zhemufengtailang57-art/edge-vibration-diagnosis/hardware/README.md

# 硬件设计

STM32F407 振动监测终端主控板 —— 原理图与 PCB Layout。

设计工具：**嘉立创EDA 专业版** V3.2.166

| 板卡规格 | |
|---|---|
| 层数 | **4 层板** —— 叠层：信号 / GND / 电源 / 信号 |
| 主控 | STM32F407ZGT6（LQFP144，168 MHz） |
| 供电 | 12V DC 输入，板载 3.3V（MP2315）/ 5V（HT7150）双路 |
| 打样 | 嘉立创 |

---

## 一、图纸索引

### 原理图（共 5 页）

| 页码 | 内容 | 图纸 | 说明 |
|---|---|---|---|
| 1 | STM32 最小系统 | [`schematic/01_STM32最小系统.png`](schematic/01_STM32最小系统.png) | 主控、时钟、复位、BOOT/SWD、VCAP/VDDA、W25Q64、去耦 |
| 2 | 电源树 | [`schematic/02_电源树.png`](schematic/02_电源树.png) | 12V 输入保护 → 3.3V (MP2315) / 5V (HT7150) |
| 3 | 传感器 | [`schematic/03_传感器.png`](schematic/03_传感器.png) | ADXL345 加速度计、DS18B20 温度传感器接线 |
| 4 | 电机与输出 | [`schematic/04_电机与输出.png`](schematic/04_电机与输出.png) | TB6612 驱动、LED 指示、蜂鸣器、电机开关 |
| 5 | 通信接口 | [`schematic/05_通信接口.png`](schematic/05_通信接口.png) | USB Type-C、ESP32、OLED、MAX13487 RS485 |

### PCB

| 内容 | 文件 |
|---|---|
| 3D 渲染图（器件装配效果） | [`pcb/VibrationMonitor_F407_3D.png`](pcb/VibrationMonitor_F407_3D.png) |
| Layout 总览（丝印 / 走线 / 器件布局） | [`pcb/VibrationMonitor_F407_PCB_Layout.png`](pcb/VibrationMonitor_F407_PCB_Layout.png) |
| 嘉立创EDA 工程源文件（可编辑） | [`VibrationMonitor_F407_嘉立创EDA工程.epru`](VibrationMonitor_F407_嘉立创EDA工程.epru) |

<p align="center">
  3D 渲染
</p>

> 工程源文件用嘉立创EDA 专业版打开：`文件 → 打开 → 选择 .epru`。

---

## 二、关键器件

| 功能 | 器件 | 封装 / 型号 | 接口 |
|---|---|---|---|
| 主控 | STM32F407ZGT6 | LQFP144，168 MHz | — |
| 振动传感器 | ADXL345 | 三轴加速度计 | SPI1 |
| 温度传感器 | DS18B20 | 1-Wire 数字温度 | GPIO |
| 存储 | W25Q64 | 8 MB SPI Flash | SPI2 |
| 显示 | OLED 128×64 | SSD1306 | I2C1 |
| 电机驱动 | TB6612FNG | 双路 H 桥 | PWM (TIM3) |
| 有线通信 | MAX13487EESA | RS485 自动方向 | USART3 |
| 无线通信 | ESP32-WROOM-32 | Wi-Fi / MQTT | USART1 |
| 电源 | MP2315GJ-Z | 同步降压 → 3.3V | — |
| 电源 | HT7150 | LDO → 5V | — |

---

## 三、电源树

```
  12V DC (DC005)
      │
      ├─ F2: SMD1206-200-16 自恢复保险丝
      │
      ├─ Q1: AO3401A PMOS 电源开关（R1 10kΩ 上拉栅极）
      │
      └─── VCC_12V ──┬──────────────────────────┐
                     │                          │
              U1: MP2315GJ-Z              U8: HT7150
              (同步降压, 2A)              (LDO)
                     │                          │
                  VCC_3V3                    VCC_5V
              (数字 / 模拟 / 传感器)      (RS485 / 蜂鸣器)
```

- 输入端 100µF 电解 + 100nF 陶瓷去耦，抑制电机启停的电流冲击
- 3.3V 侧按 VCC / VDDA / VCAP 分区去耦，模拟供电独立走线
- RS485 与蜂鸣器走 5V，避免电机噪声串扰数字域

---

## 四、设计要点

**1. 4 层板叠层：信号 / GND / 电源 / 信号**
第 2 层为完整 GND 平面，为第 1 层的高速信号（SPI 5.25 MHz、8 MHz 晶振）提供紧耦合回流路径；同时把信号层与第 3 层电源层隔开，避免电源噪声耦合进 ADXL345 这类 mG 量级的敏感模拟电路。相比两层板，四层板把回流路径从"绕行"变成"就近"，是 EMI 与信号完整性最直接的一层保险。

**2. 电源与电机隔离**
TB6612 的电机供电（VM）与逻辑供电（VCC）分开走线，各自独立去耦（C32/C33、C34）。电机是大电流感性负载，启停瞬间的反电动势容易通过电源串扰到 MCU，分区去耦是最直接的抑制手段。

**3. RS485 自动方向**
选用 MAX13487EESA 而非传统的 MAX3485 + DE 控制线方案。前者内置自动方向控制，省去一路 GPIO 和软件切换时序，代价是**波特率受内部超时限制**——实测降到 57600 会导致帧尾被提前撤销，因此固件锁定 115200（详见 `docs/调试踩坑记录.docx`）。

**4. 传感器接线端子化**
ADXL345 与 DS18B20 均通过端子（DB125-2.54-8P、WJ500V-5.08-03P）外接，而非直接焊在板上。振动传感器需要贴装在电机壳体上，走线长度和位置直接影响信号质量，端子化便于现场调整。

**5. 磁珠隔离电源**
ADXL345 供电串入 BLM18AG601SN1D 磁珠（600Ω@100MHz），抑制高频噪声从数字电源耦合进加速度计——振动信号幅度在 mG 量级，电源纹波会直接污染测量结果。

---

## 五、图纸导出说明

`schematic/` 与 `pcb/` 下的 PNG 由嘉立创EDA 导出，可直接在 GitHub 上预览，无需安装任何 EDA 工具。
`.epru` 为工程源文件，如需修改设计请用嘉立创EDA 专业版打开。
