zhemufengtailang57-art/edge-vibration-diagnosis/docs/软件交接文档_2026-08-16.md

# 软件交接文档（振动监测项目）

> 生成日期：2026-08-16
> 用途：对话上下文过长时，新对话读此文档即可恢复全部项目状态
> 配套参考：memory/project-plan.md（项目全貌）、调试踩坑记录.docx（23坑）、项目开发日志.docx

---

## 一、项目当前状态（截至 2026-08-16）

### 已完成 ✅
- 面包板全链路验证跑通：ADXL345(SPI1) / DS18B20(OneWire PB5) / OLED(I2C1) / W25Q64(SPI2) / MAX3485(USART3)
- FreeRTOS 5任务：Sensor / Display / MQTT / Modbus / Watchdog
- TIM4 1kHz 双缓冲采样（128组/块）+ MA8+MED5 滤波管线 + FFT 128点（CMSIS-DSP）
- Modbus-RTU 从站：USART3 115200，RXNE 中断 + 256B 环形缓冲，寄存器直读直写，500ms+ 轮询 100% 可靠
- MQTT：F407 USART1 发 JSON → ESP32 → WiFi → Broker（PC Mosquitto）
- IWDG 16s + TIM4 中断喂狗（500ms/次）
- 黑匣子：W25Q64 故障记录 500+ 条
- 上位机：Qt6 工业版（双视图/曲线/CSV导出）+ Grafana + 手机网页监控
- **PCB 硬件设计已完成**：5页原理图 0/0/0 ERC，4层板布局布线完成，DRC 0 错误，Gerber 已出（2026-08-16），待下单打样

### 面包板电机实测（2026-08-11 左右）
- 电机可转动；上电瞬间不乱转，F407 复位完成后开始转（固件测试代码启动）
- 面包板无 PC6/PC7 下拉电阻，PCB 版已加 10kΩ 下拉（硬件保护复位期浮空）

---

## 二、PCB 硬件与面包板的差异（固件必须知道的）

| # | 差异 | 影响 |
|---|---|---|
| 1 | **LSE 32.768kHz 外部晶振新增**（PC14/PC15） | 🔴 CubeMX 必须改 RCC LSE=Crystal，否则晶振白焊、RTC 仍跑 LSI |
| 2 | **PB0 改为蜂鸣器**（原 ESP8266 EN，已废弃） | 需新增蜂鸣器驱动代码 |
| 3 | **PA0 黄灯、PA1 红灯新增** | 需新增 LED 控制代码（绿灯 PC0 已是心跳灯，无需改） |
| 4 | **MPU6050 已从 PCB 移除** | 代码里 MPU6050_ReadAccel 读取但值未用，可删 |
| 5 | RS485 芯片 = MAX13487E（5V 供电，HT7150 单独供 5V） | 逻辑电平已验证兼容（PB11/PD8 均 FT 脚） |
| 6 | MAX13487E 无 DE 脚：Pin2=RE、Pin3=SHDN，短接后 10kΩ 上拉到 5V = AutoDirection 自动收发 | 默认 0Ω 不焊，无需代码控制方向 |
| 7 | 0Ω(DNP) 接 PC8 = 备份：焊上后 PC8 拉低 = 关断 485 芯片（软件复位用） | 不是方向控制！ |
| 8 | PC6/PC7 各 10kΩ 下拉（复位期防电机误动） | 代码无需改，Motor_Init 已有 |
| 9 | ESP32 模组 = ESP32-S3-WROOM-1（邮票孔，USB 原生烧录口） | ESP32 固件按 S3 配置（GPIO16=RX2、GPIO17=TX2） |
| 10 | USART3 115200（面包板最终配置） | modbus_slave.c:128 的 LOG 还写着"9600 8N1"，是旧日志没改 |
| 11 | 电机物理开关 SW3（12V 到 TB6612 VM 之间） | 演示时手动控制电机通断电 |

---

## 三、软件待办清单（按优先级）

### 🔴 P0：CubeMX 改 LSE（必做，不改 PCB 白焊）
1. 打开 Vibration_F407.ioc → System Core → RCC → LSE 选 **Crystal/Ceramic Resonator**
2. Clock Configuration 里 RTC 时钟源选 LSE
3. Generate Code **前先备份 main.c 全文**
4. Generate 后逐项检查（历史踩坑）：
   - MX_IWDG_Init() 位置（必须挪到 osKernelStart() 前，否则看门狗提前启动复位循环）
   - USART3 波特率是否被改回 9600（必须 115200）
   - FreeRTOS 任务函数体是否被清空（USER CODE 标记断裂，历史坑14）
   - HAL 时基 TIM6、中断优先级

### 🟡 P1：新增 PCB 输出驱动（蜂鸣器 + 黄灯 + 红灯）
初始化（main.c USER CODE BEGIN 2）：
```c
HAL_GPIO_WritePin(GPIOA, GPIO_PIN_0 | GPIO_PIN_1, GPIO_PIN_SET); // 黄/红灭（低电平亮）
HAL_GPIO_WritePin(GPIOB, GPIO_PIN_0, GPIO_PIN_RESET);             // 蜂鸣器不响
```
阈值逻辑骨架（sensorTask 每轮采样后，阈值待 AI 训练后替换）：
```c
if (fft_result.rms > 2.0f) {          // 故障：红亮+蜂鸣
    PA1=0; PA0=1; PB0=1;
} else if (fft_result.rms > 0.5f) {   // 预警：黄亮
    PA0=0; PA1=1; PB0=0;
} else {                              // 正常：全灭，绿灯心跳
    PA0=1; PA1=1; PB0=0;
}
```

### 🟡 P2：RS485 方向备份（仅当 AutoDirection 丢包才做）
- 现状：modbus_slave.c 发送用寄存器直写，未调用方向切换
- 若 115200 下丢包：焊上 0Ω，代码在 Modbus_Poll 发送前 `RS485_SetTx()`、`while(TC)` 后 `RS485_SetRx()`（函数已存在于 modbus_slave.c:102-110，只是没被调用）
- 注意：MAX13487E 拉低 RE/SHDN = 关断芯片，不是方向控制；备份用途是"软件复位 485"

### 🟢 P3：代码清理（不强制）
| 项 | 操作 |
|----|---|
| 删除 MPU6050 | mpu6050.c/h + main.c include + sensorTask 里的 ReadAccel 调用 + ax/ay/az 变量 |
| 删除 ESP8266 | esp8266.c/h + main.c include |
| I2C1 互斥锁 | 可选删（I2C1 上只剩 OLED 一个设备） |
| Modbus 日志 | modbus_slave.c:128 的 "9600 8N1" 改为 "115200 8N1" |

---

## 四、关键文件与代码位置（`firmware/`）

| 文件 | 内容 |
|---|---|
| Core/Inc/main.h | GPIO 宏定义（LED_Pin=PC0, ESP8266_Pin=PB0[已改蜂鸣器], RS485_DE_Pin=PC8, W25Q64_CS_Pin=PB12） |
| Core/Src/main.c | 5 任务 + SystemClock_Config(168MHz) + sensorTask 主逻辑 + TIM4 回调喂狗 |
| Core/Src/adxl345_dma.c | 双缓冲采样，ADXL_DMA_TIM4_ISR 在 TIM4 中断里调 |
| Core/Src/filter.c | MA(8)+MED(5) 滤波管线 |
| Core/Src/fft_analyzer.c | 128 点 RFFT + RMS + 峰值搜索（RMS<10mg 判静止 valid=0） |
| Core/Src/modbus_slave.c | Modbus 从站（0x03/0x04/0x06，寄存器表 7+2），USART3 寄存器直写，RS485_SetTx/Rx 已定义未调用 |
| Core/Src/motor.c | TB6612：Motor_Init/Start/Stop/Forward/Reverse/SetSpeed(0-999) |
| Core/Src/w25q64.c | Flash 驱动 + 黑匣子（BLACKBOX_ADDR=4096，500 条×16B） |
| Core/Src/ds18b20.c | OneWire PB5，DWT 微秒延时，12bit |
| Core/Src/mqtt_simple.c | MQTT v3.1.1 手动协议栈（ESP8266 AT 遗留，ESP32 方案已改 USART1 直发 JSON） |
| Core/Src/stm32f4xx_hal_msp.c | PB11 已手动加 GPIO_PULLUP（生成代码别覆盖） |
| Vibration_F407.ioc | CubeMX 配置（改 LSE 用） |

### 引脚分配锁定表（PCB 已按此设计，不可改）
- USART1: PA9(TX)/PA10(RX) → ESP32
- USART2: PA2/PA3 → 调试
- USART3: PD8(TX)/PB11(RX) → MAX13487E
- PC8: RS485_DE（0Ω 备份）
- I2C1: PB6/PB7 → OLED
- SPI1: PA5/PA6/PA7 + PA4(CS) → ADXL345
- SPI2: PB10(SCK)/PC2(MISO)/PC3(MOSI) + PB12(CS) → W25Q64 ⚠️ 非标引脚
- TIM3_CH4: PB1 → 电机 PWM 1kHz
- PC6/PC7: 电机 AIN1/AIN2；PB2: STBY+BOOT1
- PB5: DS18B20
- PC0: 绿 LED；PA0: 黄；PA1: 红；PB0: 蜂鸣器

---

## 五、下一个里程碑（PCB 到货后）

1. **打样等待期**（1-2 周）：改 CubeMX LSE + 补蜂鸣器/LED 驱动 + 代码清理
2. **PCB 焊接**：先电源区测 3.3V/5V → 焊 F407 测 SWD → W25Q64 → RS485 → ESP32 烧录 → 电机最后上电
3. **上电测试清单**：万用表测 3V3/GND 无短路 → 只插电源测三轨电压 → ST-Link 读 ID → 烧面包板固件看 OLED/串口
4. **AI 模型训练**：PC 采集 → FFT 特征 → MLP/CNN/LGB 对比 → int8 量化 → Cube.AI 部署
5. **阈值标定**：替换 P1 里的 0.5/2.0 占位阈值
6. **外壳**：立创铝型材外壳 + 前面板开孔（OLED 窗口/三色灯孔/开关孔/端子口）
7. **文档**：更新项目开发日志 + 调试踩坑记录（软硬联调审计结果可入文档）

---

## 六、教学方式铁律（新对话必须遵守）

1. 每一步列完整操作细节（点哪个菜单、选什么、填什么值）
2. 代码写在哪、USER CODE BEGIN/END 哪个块之间要讲清楚
3. 出错了先要现象描述 → 分析根因 → 给修复步骤，不让用户自己猜
4. CubeMX Generate Code 必毁三样：IWDG 位置、波特率、USER CODE 块——每次生成后检查
5. 用户指出错误时，承认并立即修正，不狡辩
6. 一切以跑通版本为准，不确定的先问再动
