zhemufengtailang57-art/edge-vibration-diagnosis/docs/CubeMX配置速查手册.docx

# STM32CubeMX 配置速查手册 (Vibration_F407项目)

芯片: STM32F407ZGT6 | 封装: LQFP144 | CubeMX版本: 6.17.0

# 一、初始工程配置

## 1.1 新建工程

打开CubeMX → File → New Project → 选STM32F407ZGTx

Pinout → System Core → SYS:

Debug: Serial Wire (⚠️ 必须配!否则ST-Link连不上)

Pinout → System Core → RCC:

High Speed Clock(HSE): Crystal/Ceramic Resonator

Clock Configuration:

HSE=8MHz → PLLM=/8 → PLLN=×168 → PLLP=/2 → SYSCLK=168MHz

APB1=/4=42MHz, APB2=/2=84MHz

Project Manager → Project Name: Vibration_F407

Toolchain: MDK-ARM V5.32

⚠️ 勾选 "Keep User Code when re-generating"

## 1.2 每次Generate后必检查

⚠️ 删除 peripheral init区多余的 MX_IWDG_Init()

⚠️ 删除 osKernelStart()后的孤儿 while(1){}

⚠️ 确认任务优先级没被重置(all Normal→需手动改回)

⚠️ 确认 sensorTask 函数体没被清空(USER CODE 5→StartSensorTask)

# 二、外设配置

## 2.1 USART2 — 调试串口 printf (PA2/PA3)

Connectivity → USART2 → Mode: Asynchronous

Parameter Settings: Baud=115200, 8N1

代码: fputc重定向到huart2, Keil勾选Use MicroLIB

## 2.2 USART1 — ESP8266 WiFi (PA9/PA10)

Connectivity → USART1 → Mode: Asynchronous

Parameter Settings: Baud=115200, 8N1

⚠️ 正点原子板: 拔掉PA9-RX/PA10-TX的跳帽!

代码: PB0=GPIO_Output(EN), 独立3.3V供电(不接ST-Link)

## 2.3 USART3 — RS485 Modbus (PD8/PB11)

Connectivity → USART3 → Mode: Asynchronous

Parameter Settings: Baud=115200, 8N1

PC8: GPIO_Output = RS485_DE (收发控制, HIGH=TX, LOW=RX)

## 2.4 I2C1 — OLED+MPU6050 (PB6/PB7)

Connectivity → I2C1 → Mode: I2C

Parameter Settings: Standard Mode, 100kHz

GPIO Settings: PB6/PB7 → Alternate Function Open Drain + Pull-up

💡 两个设备同总线, 地址不同(OLED=0x3C, MPU=0x68) — 互斥锁保护

## 2.5 SPI1 — ADXL345 (PA4=CS, PA5=SCK, PA6=MISO, PA7=MOSI)

Connectivity → SPI1 → Mode: Full-Duplex Master

Parameter Settings:

Data Size=8Bit, MSB First

CPOL=High, CPHA=2 Edge (Mode 3)

NSS=Software (手动CS)

Baud Rate Prescaler=16 → 5.25MHz

PA4: GPIO_Output = CS (不选SPI1_NSS, 软件控制)

⚠️ PA5同时是之前LED脚 → LED移走(PC0)

## 2.6 SPI2 — W25Q64 Flash (PB10=SCK, PC2=MISO, PC3=MOSI, PB12=CS)

Connectivity → SPI2 → Mode: Full-Duplex Master

Parameter Settings:

CPOL=Low, CPHA=1 Edge (Mode 0)

NSS=Software

Baud Rate=16 → 2.625MHz (APB1/16=42/16)

PB12: GPIO_Output = CS

💡 SPI2引脚映射是PB10/PC2/PC3,不是常见的PB13/14/15 — CubeMX自动选的

## 2.7 PB5 — DS18B20 OneWire

GPIO → PB5: GPIO_Output (驱动代码里动态切换输入/输出)

⚠️ 不需要CubeMX配置OneWire — 纯软件模拟, DWT计时

硬件: 4.7kΩ上拉电阻在VCC和DATA之间

# 三、定时器与PWM

## 3.1 TIM3 CH4 — TB6612电机PWM (PB1)

Timers → TIM3 → Clock Source: Internal Clock

Channel 4: PWM Generation CH4

Parameter Settings:

Prescaler=83 → 1MHz (84M/84)

Counter Period=999 → 1kHz PWM

Auto-reload=Enable

PB1自动变TIM3_CH4 (AF2)

💡 1kHz是电机PWM最优频率 — 噪声和效率折中

## 3.2 TIM4 — ADXL345 1kHz采样触发

Timers → TIM4 → Clock Source: Internal Clock

Parameter Settings:

Prescaler=83, Counter Period=999 → 1kHz

NVIC Settings → TIM4 global interrupt → 勾选 ✅

⚠️ 不要配任何Channel — TIM4只当中断闹钟用

代码: HAL_TIM_PeriodElapsedCallback里读取ADXL345

## 3.3 SYS Timebase → TIM6 (FreeRTOS启用后必配)

System Core → SYS → Timebase Source: TIM6

⚠️ FreeRTOS启用后必须改!否则SysTick冲突

⚠️ 每次新建工程配完FreeRTOS后立即改这个

# 四、FreeRTOS 完整配置

## 4.1 启用FreeRTOS

Middleware → FREERTOS → Interface: CMSIS_V2

Config parameters:

TOTAL_HEAP_SIZE = 20480 (20KB)

TICK_RATE_HZ = 1000

⚠️ 立刻去SYS把Timebase改成TIM6!

## 4.2 添加任务 (Tasks标签)

点击Add, 逐一添加5个任务:

sensorTask: Priority=osPriorityAboveNormal, Stack=1024×4=4096B

displayTask: Priority=osPriorityNormal, Stack=512×4=2048B

mqttTask: Priority=osPriorityNormal, Stack=1024×4=4096B

modbusTask: Priority=osPriorityNormal, Stack=512×4=2048B

watchdogTask: Priority=osPriorityBelowNormal, Stack=256×4=1024B

💡 优先级: AboveNormal(采集) > Normal(显示/通信) > BelowNormal(监控)

💡 Stack: sensor/mqtt要4KB(FFT数组/MQTT缓冲), 其他2KB够了

## 4.3 互斥锁 (Mutexes标签)

点击Add → Name: i2c1Mutex

代码: osMutexAcquire/Release 保护I2C1总线

CubeMX生成的句柄: i2c1MutexHandle

用法:

osMutexAcquire(i2c1MutexHandle, osWaitForever);

// ... I2C操作 ...

osMutexRelease(i2c1MutexHandle);

## 4.4 队列 (Queues标签) — 当前未用

点击Add → Name: sensorQueue, Size=16, Type=uint16_t

💡 队列已创建但未使用, 当前用Task Notification替代

💡 以后加AI任务或更多消费者时用队列分发数据

# 五、看门狗IWDG

## 5.1 IWDG 配置

System Core → IWDG → Activated ✅

Prescaler=128, Reload value=4095 → 16秒超时

⚠️ CubeMX在peripheral init区插入 MX_IWDG_Init()

⚠️ 必须手动删除! 在main()末尾(while前)调用

正确初始化顺序:

1. 所有外设Init

2. 所有传感器检测

3. ESP8266 WiFi连接

4. MX_IWDG_Init() ← 最后一步

5. osKernelStart()

喂狗: 在TIM4中断回调里, 每500ms HAL_IWDG_Refresh(&hiwdg)

💡 在中断喂狗比在任务喂狗可靠100倍(不受任务调度影响)

# 六、GPIO快速参考

## 引脚分配总表

PA2=USART2_TX, PA3=USART2_RX (printf调试串口)

PA4=ADXL345_CS (SPI1软件CS, GPIO_Output)

PA5=SPI1_SCK, PA6=SPI1_MISO, PA7=SPI1_MOSI (ADXL345)

PA9=USART1_TX, PA10=USART1_RX (ESP8266, 拔跳帽!)

PA13=SWDIO, PA14=SWCLK (ST-Link, 勿动!)

PB0=ESP_EN (GPIO_Output, 高电平使能ESP8266)

PB1=TIM3_CH4 (电机PWM, 1kHz)

PB5=DS18B20 OneWire (GPIO, 4.7k上拉)

PB6=I2C1_SCL, PB7=I2C1_SDA (OLED+MPU6050共享)

PB10=SPI2_SCK, PC2=SPI2_MISO, PC3=SPI2_MOSI (W25Q64)

PB11=USART3_RX, PD8=USART3_TX (RS485 Modbus)

PB12=W25Q64_CS (SPI2软件CS, GPIO_Output)

PC0=LED (GPIO_Output, 500ms闪烁)

PC6/PC7=TB6612 AIN1/AIN2 (电机方向, GPIO_Output)

PC8=RS485_DE (收发控制, GPIO_Output)

PH0=OSC_IN, PH1=OSC_OUT (HSE 8MHz晶振)

# 七、常见踩坑速查

## 每次CubeMX Generate后必做

1. 打开main.c → 删 peripheral init 区的 MX_IWDG_Init()

2. 删 osKernelStart() 后的孤儿 while(1){} 块

3. 检查任务优先级(每个Task属性里改: sensor=AboveNormal, mqtt=Normal, watchdog=BelowNormal)

4. 检查 SYS Timebase= TIM6

5. 检查 sensorTask 函数体是否被清空(StartSensorTask → 如果被清空,重写)

6. 检查 FreeRTOSConfig.h → configENABLE_FPU? (F407有硬浮点)

7. F7编译 → 有孤儿while错误 → 删孤儿块 + 补 /* USER CODE BEGIN 3 */ 和 }

8. Keil Options: C/C++ → Define → ARM_MATH_CM4 (FFT用DSP库)

9. Keil Options: Target → Floating Point = Single Precision

# 八、工具链版本

CubeMX: 6.17.0 | HAL: STM32Cube FW_F4 V1.28.3 | Keil: MDK-ARM V5.32 | 编译器: ARMCC V5.06

FreeRTOS: V10.3.1 (CMSIS_V2 wrapper) | CMSIS-DSP: V1.9.0 | Node-RED: V5.0.1
