zhemufengtailang57-art/edge-vibration-diagnosis/hardware/schematic/01_STM32最小系统.png

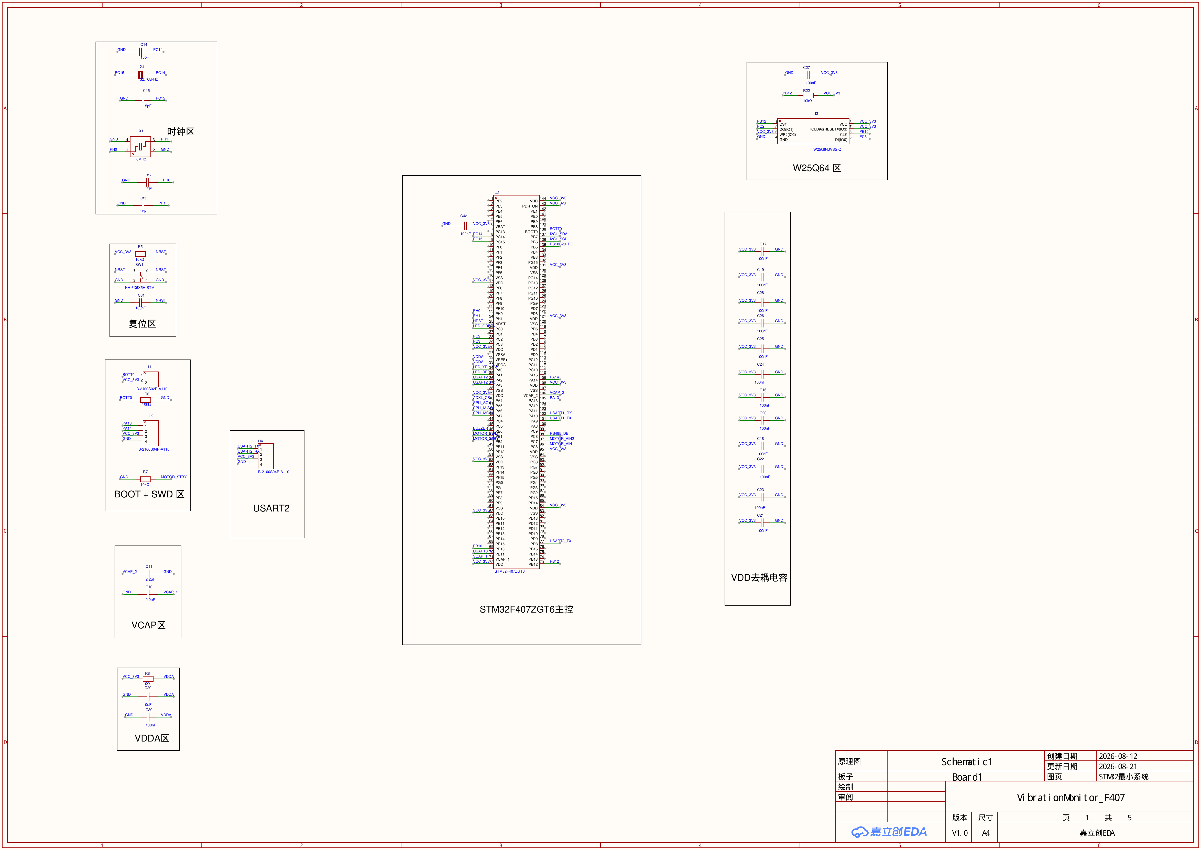
hardware/schematic/01_STM32最小系统.png
