zhemufengtailang57-art/edge-vibration-diagnosis/hardware/schematic/02_电源树.png

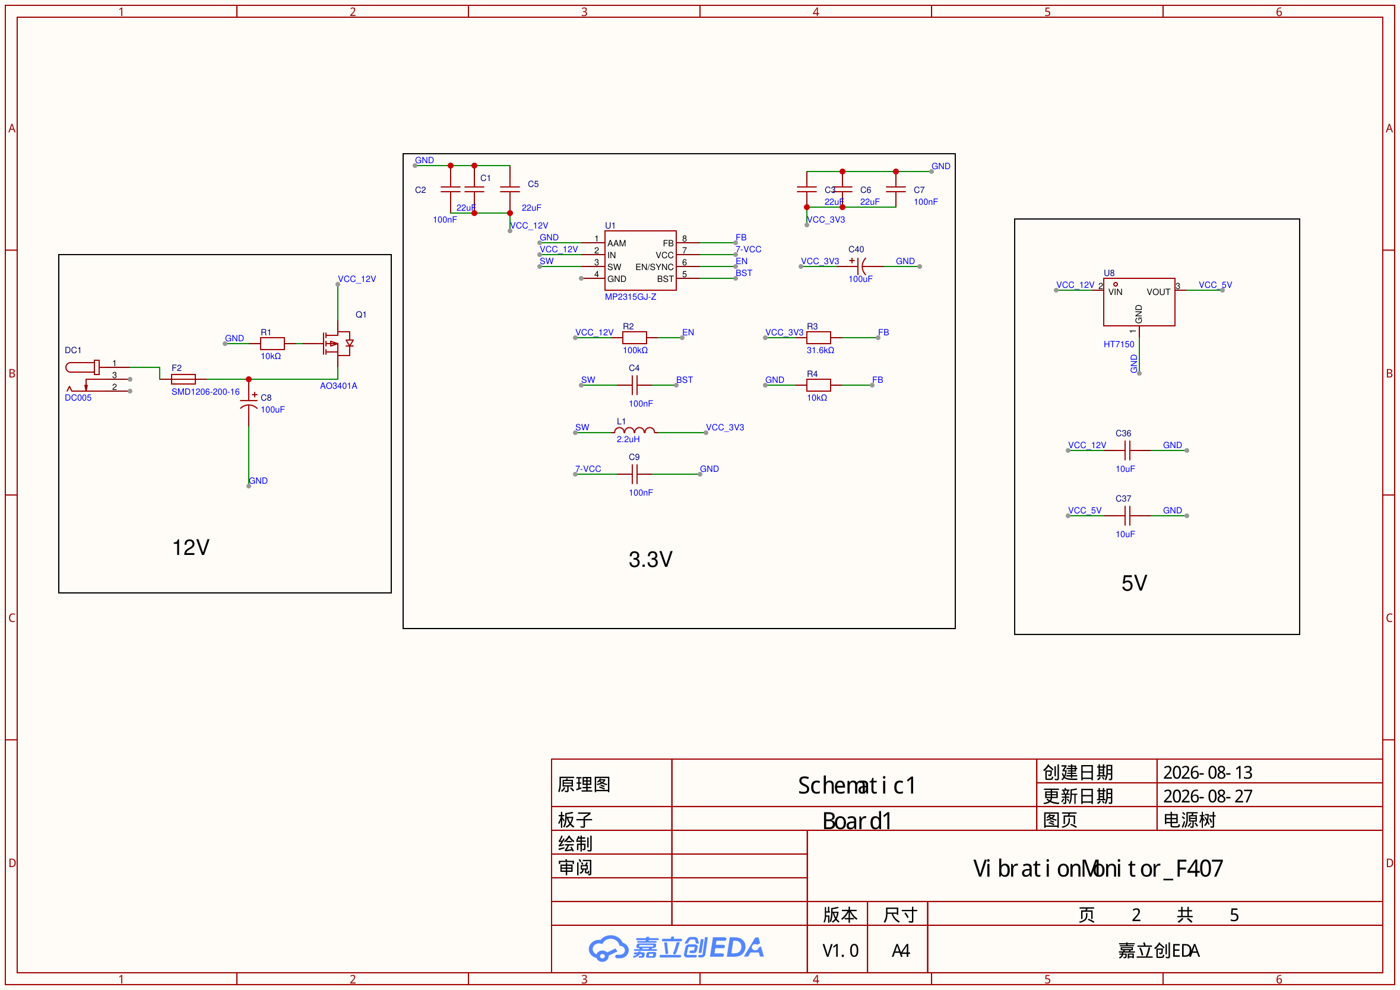
hardware/schematic/02_电源树.png
