zhemufengtailang57-art/edge-vibration-diagnosis/hardware/schematic/03_传感器.png

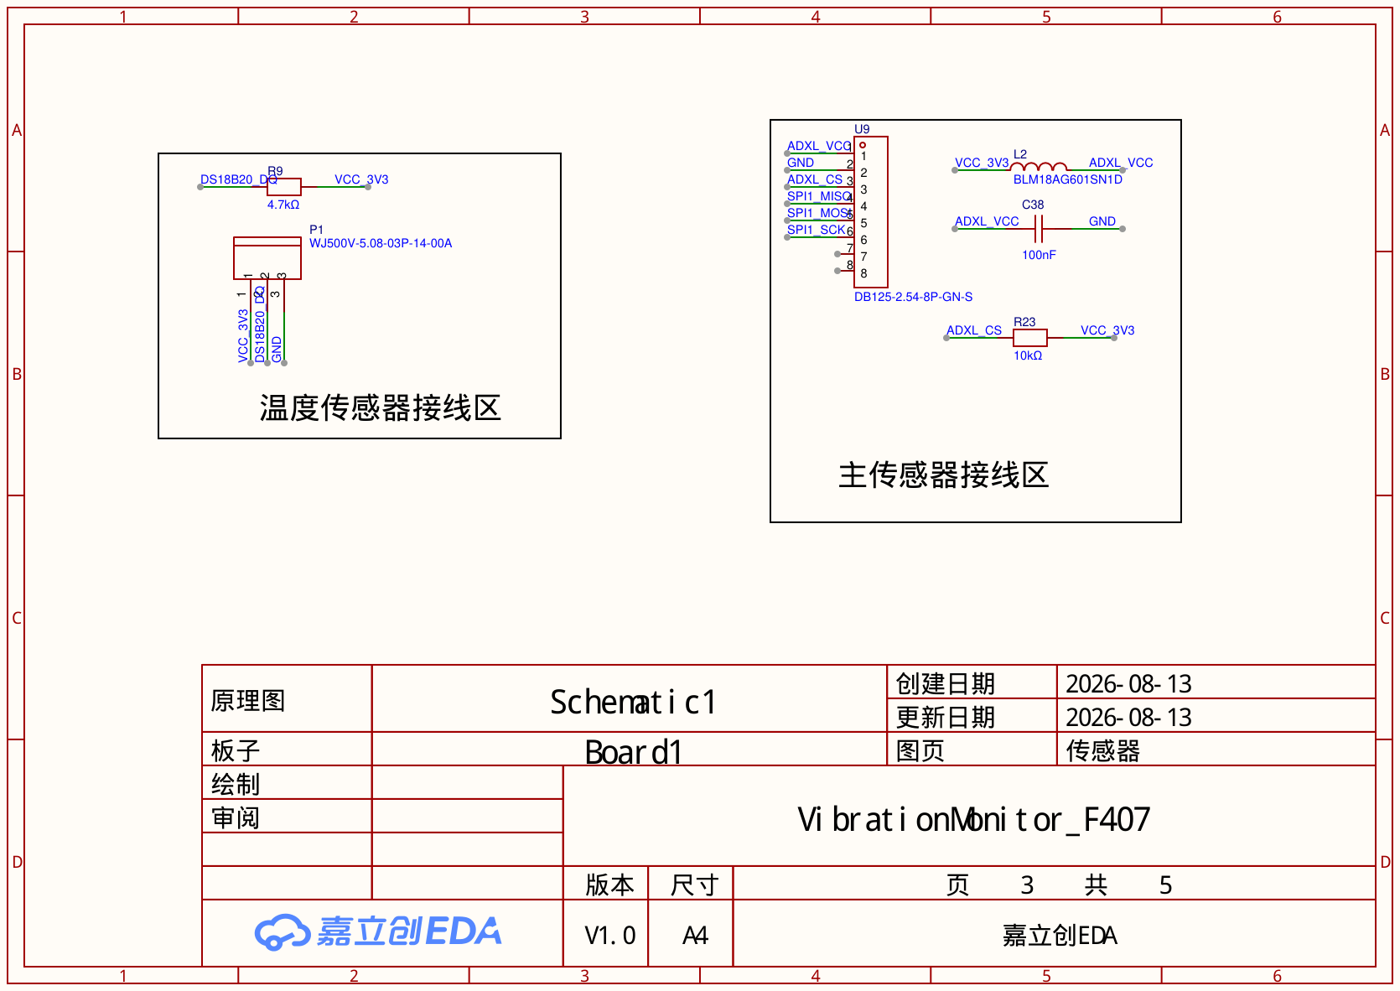
hardware/schematic/03_传感器.png
