zhemufengtailang57-art/edge-vibration-diagnosis/hardware/schematic/04_电机与输出.png

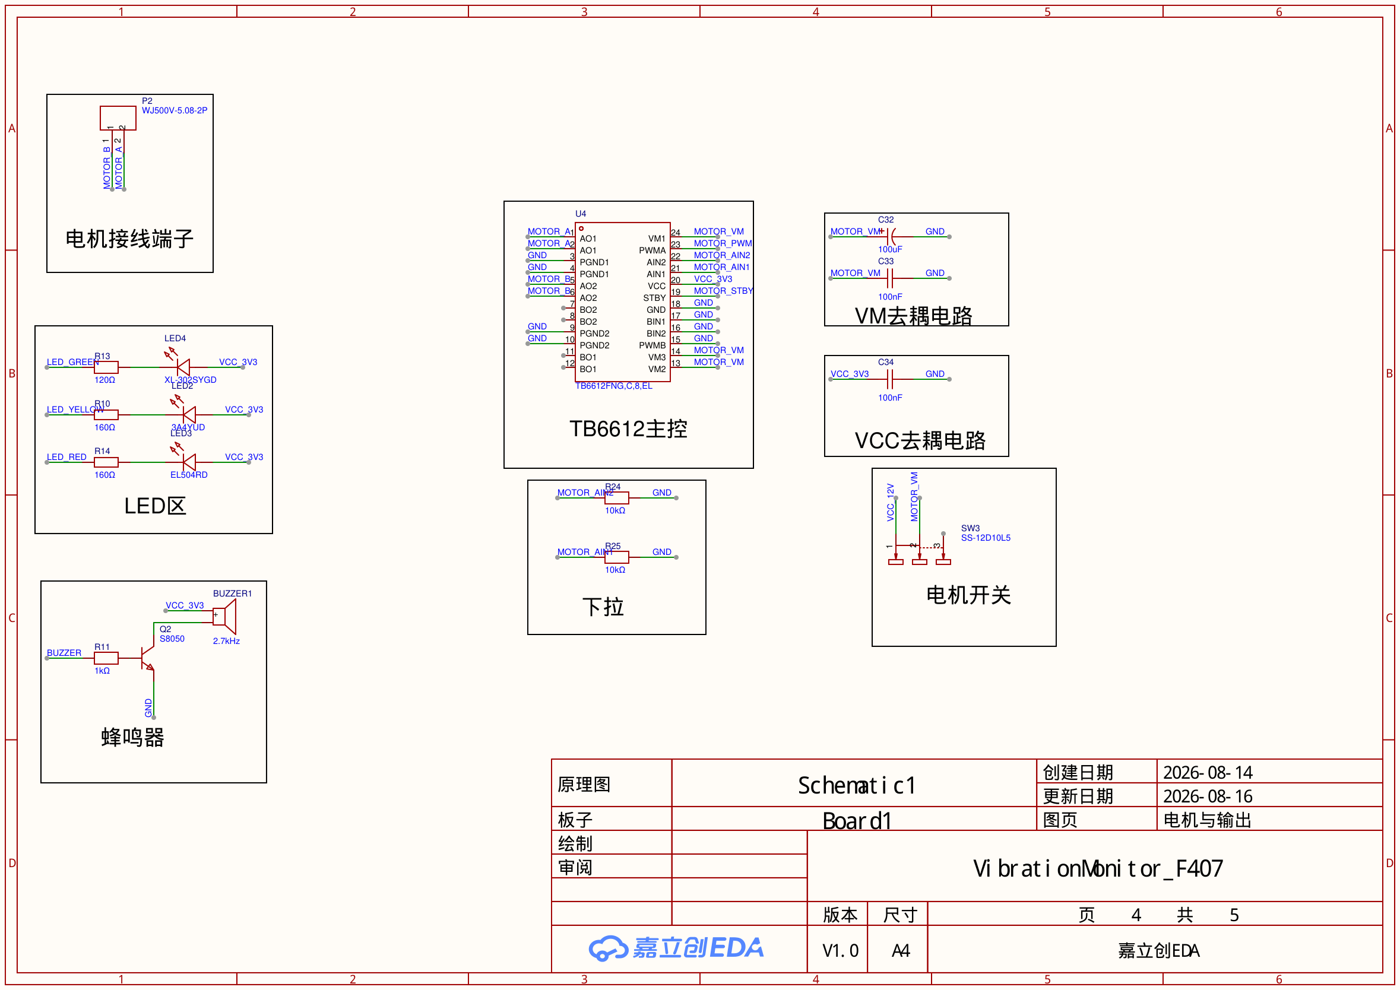
hardware/schematic/04_电机与输出.png
