zhemufengtailang57-art/edge-vibration-diagnosis/hardware/schematic/05_通信接口.png

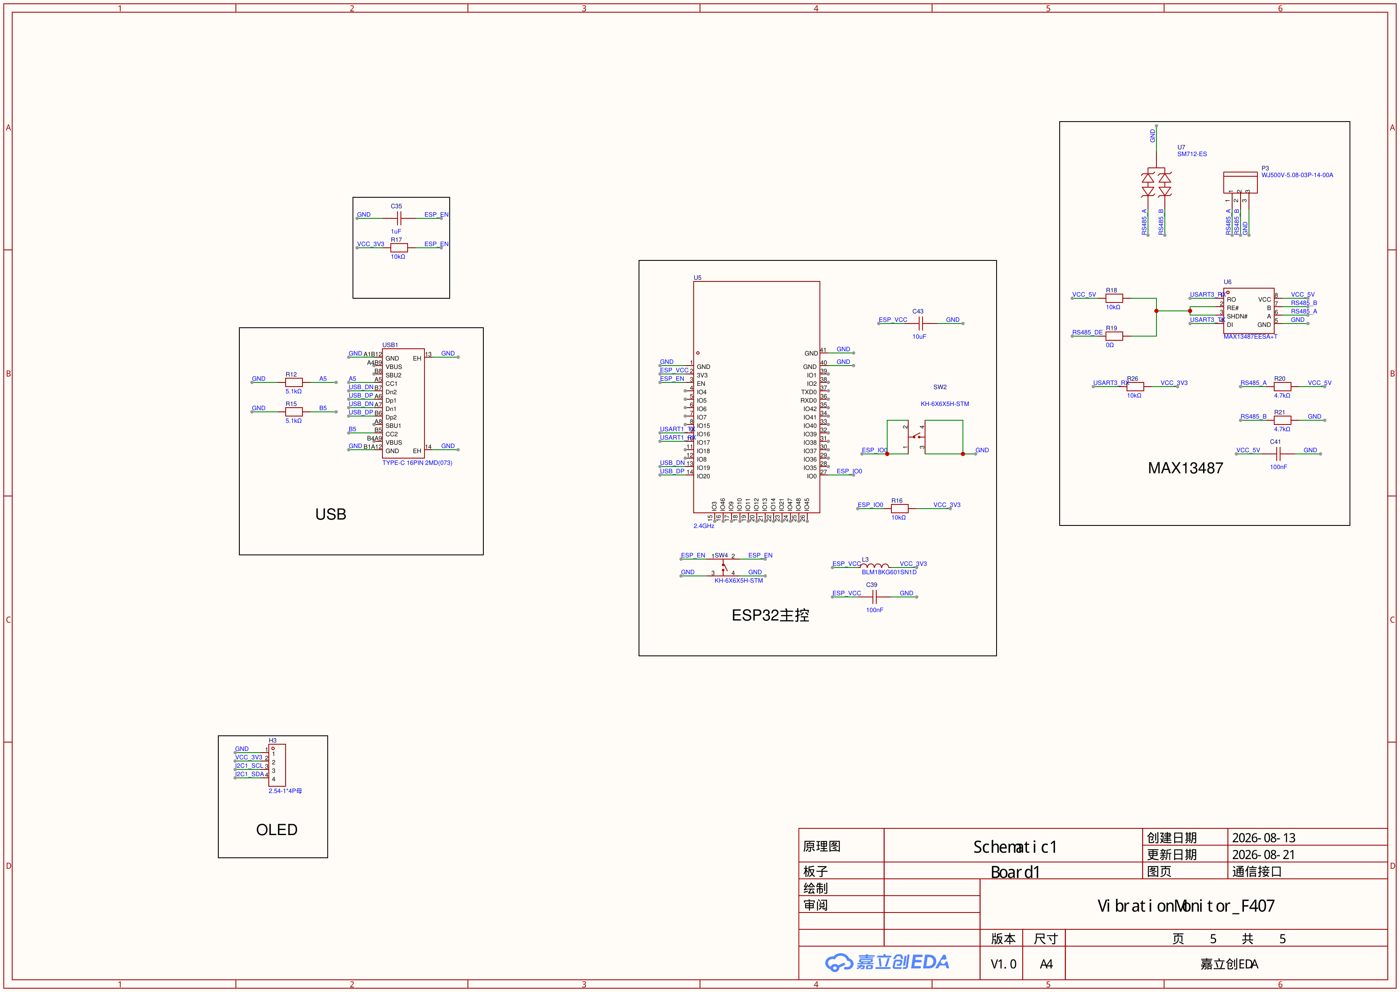
hardware/schematic/05_通信接口.png
