zhemufengtailang57-art/edge-vibration-diagnosis/docs/调试踩坑记录.docx

工业振动监测项目 — 调试踩坑记录

（STM32F407 + FreeRTOS + Modbus + MQTT + 边缘AI）

文档说明：本文档记录项目开发过程中全部真实遇到的 Bug、排查过程和解决方案。每个坑均按"现象 → 排查 → 根因 → 解决 → 教训"五段式整理，可在面试中作为"我有实际调试经验"的证明材料逐一讲述。

项目周期：2026年7月23日 ~ 2026年8月18日 总踩坑：26 个（原27条含1条重复，已合并）

分类总览：硬件接线(3) 供电(1) 看门狗(3) 传感器(3) 通信(7) CubeMX/工具(2) Qt上位机(5) 黑匣子/存储(1) FreeRTOS(1)

一、硬件接线类

━━━━━━━━━━━━━━━━━━━━━━━━━━━━━━━━━━━━━━━━━━ 第1坑 ━━━━━━━━━━━━━━━━━━━━━━━━━━━━━━━━━━━━━━━━━━

【USB转TTL接错GND到3.3V】

日期：2026-07-24

【现象】ST-Link不亮、F407发热、串口无输出

【排查】逐一检查接线，发现USB转TTL的GND接到了F407的3.3V引脚

【根因】F407引脚密集，丝印小，没仔细看就把GND插到了旁边3.3V脚

【解决】重新接线前先看丝印确认；USB转TTL只接TX/RX/GND三根，VCC悬空

【教训】每次接线前先确认引脚功能；VCC永远不要多源供电

━━━━━━━━━━━━━━━━━━━━━━━━━━━━━━━━━━━━━━━━━━ 第2坑 ━━━━━━━━━━━━━━━━━━━━━━━━━━━━━━━━━━━━━━━━━━

【面包板电源轨道搞反】

日期：2026-07-25

【现象】DS18B20防水探头严重发烫

【排查】检查发现红线接的是蓝轨(GND)而不是红轨(3.3V)

【根因】忘记面包板电源模块的上方轨道是GND、下方是VCC

【解决】立即断电，正确接线后探头恢复正常（DS18B20有防反接保护）

【教训】面包板红蓝轨的对应关系要形成肌肉记忆

━━━━━━━━━━━━━━━━━━━━━━━━━━━━━━━━━━━━━━━━━━ 第3坑 ━━━━━━━━━━━━━━━━━━━━━━━━━━━━━━━━━━━━━━━━━━

【PA9/PA10被板载CH340占用】

日期：2026-07-24

【现象】ESP8266-01S无法通过USART1通信

【排查】发现正点原子开发板默认用PA9/PA10接板载USB转串口

【根因】板子的RX/TX跳帽把PA9/PA10连到了CH340G上

【解决】拔掉RX/TX跳帽释放引脚

【教训】用开发板前先看原理图，确认引脚没有被板载外设占用

二、供电类

━━━━━━━━━━━━━━━━━━━━━━━━━━━━━━━━━━━━━━━━━━ 第4坑 ━━━━━━━━━━━━━━━━━━━━━━━━━━━━━━━━━━━━━━━━━━

【ESP8266峰值电流导致ST-Link掉电】

日期：2026-07-24

【现象】ST-Link不亮、ESP8266蓝灯不闪烁

【排查】逻辑推理：ESP8266启动瞬间300mA+，ST-Link 3.3V输出只有500mA还要供F407

【根因】ST-Link的3.3V LDO供电不足，ESP8266 WiFi发射瞬间电压跌落导致反复重启

【解决】ESP8266改用面包板电源模块3.3V独立供电，F407由ST-Link供电，两个电源共GND

【教训】WiFi模块必须独立供电；不同供电来源必须共GND

三、看门狗类

━━━━━━━━━━━━━━━━━━━━━━━━━━━━━━━━━━━━━━━━━━ 第5坑 ━━━━━━━━━━━━━━━━━━━━━━━━━━━━━━━━━━━━━━━━━━

【IWDG启动过早导致ESP8266反复重启发烫】

日期：2026-07-25

【现象】ESP8266金属屏蔽罩发烫，系统不断复位

【排查】定位到看门狗在peripheral init区被启动，初始化耗时7-10秒远超16秒超时

【根因】IWDG启动过早 → 初始化未完成就复位 → ESP8266反复被EN信号重启 → 发烫

【解决】将MX_IWDG_Init()移到初始化末尾（任务启动前一刻）

【教训】看门狗必须在初始化全部完成后才启动；CubeMX每次Generate都会把IWDG加回peripheral init区，需手动处理

━━━━━━━━━━━━━━━━━━━━━━━━━━━━━━━━━━━━━━━━━━ 第6坑 ━━━━━━━━━━━━━━━━━━━━━━━━━━━━━━━━━━━━━━━━━━

【CubeMX Generate后复位循环】

日期：2026-07-26

【现象】每次CubeMX Generate Code后系统不断复位

【排查】串口日志显示初始化到WiFi连接阶段就复位

【根因】CubeMX自动在peripheral init区插入MX_IWDG_Init()，16秒超时跟不上初始化速度

【解决】每次Generate后手动删除peripheral init区的MX_IWDG_Init()

【教训】CubeMX有已知行为模式，记住哪些配置它每次会覆盖（IWDG位置/波特率/USER CODE）

━━━━━━━━━━━━━━━━━━━━━━━━━━━━━━━━━━━━━━━━━━ 第7坑 ━━━━━━━━━━━━━━━━━━━━━━━━━━━━━━━━━━━━━━━━━━

【MQTT重连期间看门狗复位】

日期：2026-07-26

【现象】WiFi断线后mqttTask自动重连 → 系统复位

【排查】发现mqttTask优先级High，重连耗时18秒，期间watchdogTask无法运行

【根因】看门狗喂狗依赖任务调度，高优先级任务阻塞导致低优先级watchdogTask得不到CPU

【解决】将看门狗喂狗移到TIM4中断服务程序（ISR优先级最高，不受任务调度影响）

【教训】关键硬件保护（看门狗）必须放在中断里，不能依赖任务调度

四、传感器类

━━━━━━━━━━━━━━━━━━━━━━━━━━━━━━━━━━━━━━━━━━ 第8坑 ━━━━━━━━━━━━━━━━━━━━━━━━━━━━━━━━━━━━━━━━━━

【MPU6050 WHO_AM_I返回0x70而非0x68】

日期：2026-07-24

【现象】初始化失败，返回"WHO_AM_I Mismatch"

【排查】串口打印WHO_AM_I实际值=0x70

【根因】淘宝购买的MPU6050模块使用国产兼容芯片，ID为0x70

【解决】将驱动的WHO_AM_I校验值从0x68改为0x70

【教训】国产芯片可能有寄存器差异，先打印实际值再修改驱动

━━━━━━━━━━━━━━━━━━━━━━━━━━━━━━━━━━━━━━━━━━ 第9坑 ━━━━━━━━━━━━━━━━━━━━━━━━━━━━━━━━━━━━━━━━━━

【ADXL345静止时FFT显示虚假40-60Hz】

日期：2026-07-26

【现象】传感器静止时OLED显示Freq: 23~60Hz乱跳

【排查】分析FFT输出：DC分量最大但被跳过，噪声随机bin成了峰值

【根因】FFT无条件取最高bin作为峰值，静止时噪声幅值被当作信号

【解决】增加RMS阈值判断（RMS<10mg视为静止，valid=0，显示"---Hz"）

【教训】频域分析必须加阈值过滤，纯噪声的频谱没有参考价值

━━━━━━━━━━━━━━━━━━━━━━━━━━━━━━━━━━━━━━━━━━ 第10坑 ━━━━━━━━━━━━━━━━━━━━━━━━━━━━━━━━━━━━━━━━━━

【滤波器预热导致响应慢3秒】

日期：2026-07-26

【现象】手移动ADXL345后OLED值延迟3秒才变化

【排查】计算发现MA(8)+MED(5)需要13个样本填满窗口，主循环200ms/次×13=2.6秒

【根因】滤波管线每次主循环只喂1个样本，窗口填充缓慢

【解决】双缓冲拿到128个采样后全量喂入滤波管线 + 预热函数PreFill

【教训】滤波器状态机的预热必须在初始化时完成，不能靠运行时慢慢积累

五、通信类

━━━━━━━━━━━━━━━━━━━━━━━━━━━━━━━━━━━━━━━━━━ 第11坑 ━━━━━━━━━━━━━━━━━━━━━━━━━━━━━━━━━━━━━━━━━━

【HAL库UART状态机bug：所有串口收发全不通（项目最大难题）】

日期：2026-07-28 ~ 07-29

【现象】USART1/2/3全部收发不通，Modbus超时，printf无输出；但系统本身正常运行

【排查】耗时2天，排查12个方向：A/B极性对调、RS485共地、换Modbus工具、换USB-RS485模块、交换TX/RX、波特率偏差、波特率扫描、CubeMX代码破坏、USART1 vs USART3对照、寄存器直读vs HAL、代码合并错误、轮询速率匹配。最终锁定HAL层

【根因】HAL_UART_Receive(&huart,&ch,1,1)超时后UART状态未正确回到READY，后续调用全部返回HAL_TIMEOUT；HAL_UART_Transmit同样卡死。影响所有USART，不在ST官方已知问题列表

【解决】完全抛弃HAL库UART API，改为寄存器直读直写（USARTx->SR/DR），同时修复3个文件：modbus_slave.c RX/TX全寄存器化、log.c printf寄存器化（LOG调用从100ms降到<1ms）、hal_msp.c PB11添加上拉

【教训】HAL库不是100%可靠，硬件行为正常但API持续报错时直接寄存器操作验证；A/B对照实验（USART1 vs USART3）和自环测试是最强调试武器；115200下轮询式接收不可靠（字节间隔87μs<1ms轮询），必须中断接收

━━━━━━━━━━━━━━━━━━━━━━━━━━━━━━━━━━━━━━━━━━ 第12坑 ━━━━━━━━━━━━━━━━━━━━━━━━━━━━━━━━━━━━━━━━━━

【ESP8266固件不支持MQTT AT指令】

日期：2026-07-25

【现象】AT+MQTTUSERCFG返回ERROR

【排查】串口直发AT+MQTTUSERCFG确认固件不支持

【根因】ESP8266-01S出厂AT固件版本较低，不含MQTT命令集

【解决】不刷固件——手动构造MQTT CONNECT/PUBLISH协议帧，通过AT+CIPSEND/TCP发送

【教训】面试价值："手动实现了MQTT v3.1.1协议的帧封装，包括可变长度编码和CONNECT/PUBLISH报文"

━━━━━━━━━━━━━━━━━━━━━━━━━━━━━━━━━━━━━━━━━━ 第13坑 ━━━━━━━━━━━━━━━━━━━━━━━━━━━━━━━━━━━━━━━━━━

【MQTT CONNECT发送失败（缓冲区残留）】

日期：2026-07-26

【现象】AT+CIPSEND成功后发送MQTT包，收到的是旧的AT响应而不是"SEND OK"

【排查】ESP8266的接收缓冲区未在发送前清空

【根因】ESP8266_SendCmd填充了rx_buf，后续发原始数据后ESP8266_GetRxBuf仍读到旧缓冲

【解决】在AT+CIPSEND成功后、发原始数据前调用ESP8266_ClearRxBuf

【教训】共享缓冲区的读写顺序至关重要，清空+发送+重新接收三步不可颠倒

━━━━━━━━━━━━━━━━━━━━━━━━━━━━━━━━━━━━━━━━━━ 第14坑 ━━━━━━━━━━━━━━━━━━━━━━━━━━━━━━━━━━━━━━━━━━

【mqttTask因优先级过低饿死】

日期：2026-07-26

【现象】sensorTask通知mqttTask后，osThreadFlagsWait不返回

【排查】日志显示Notify发出但Woke迟到6秒

【根因】mqttTask优先级osPriorityLow，被sensorTask(AboveNormal)+displayTask(Normal)永久抢占CPU

【解决】调至osPriorityNormal与displayTask同级

【教训】FreeRTOS优先级分层：采集>显示=通信>监控，通信任务不能低于Normal

━━━━━━━━━━━━━━━━━━━━━━━━━━━━━━━━━━━━━━━━━━ 第15坑 ━━━━━━━━━━━━━━━━━━━━━━━━━━━━━━━━━━━━━━━━━━

【RS485 115200@500ms轮询仅25%成功率】

日期：2026-08-08

【现象】Modbus 500ms间隔轮询成功率仅约25%，1000ms间隔则10/10全通

【排查】Qt和Python均25%成功率 → 排除上位机 → 定位RS485方向切换时序

【根因】廉价RS485自动收发模块方向切换需要恢复时间，500ms太紧导致收发逻辑冲突

【解决】采集间隔调整为1000ms（工业Modbus标准轮询速度），添加发送锁m_pending防重叠

【教训】硬件特性制约软件频率；工业标准1s轮询远低于硬件极限500ms时，应排查通信链路而非代码

━━━━━━━━━━━━━━━━━━━━━━━━━━━━━━━━━━━━━━━━━━ 第16坑 ━━━━━━━━━━━━━━━━━━━━━━━━━━━━━━━━━━━━━━━━━━

【日志系统关全局中断导致Modbus间歇性CRC错误】

日期：2026-08-18

【现象】黑匣子读取随机失败（CRC错误率10-30%），而1000ms轮询100%正常

【排查】F407侧HEX抓帧证明响应帧内容正确 → 排除从站 → 定位到log.c

【根因】Log_Write用__disable_irq关全局中断保护日志输出，期间USART3 RXNE中断被屏蔽，主站请求字节丢失。sensorTask每200ms打一条Loop cnt日志 = 每200ms有4-5ms接收盲区

【解决】改用vTaskSuspendAll/xTaskResumeAll（调度器锁不关中断）；调度器启动前用xTaskGetSchedulerState判断，走关中断分支

【教训】关全局中断是最昂贵的操作，必须知道关了多久；低频轮询会掩盖丢字节问题，高频连续通信才暴露

━━━━━━━━━━━━━━━━━━━━━━━━━━━━━━━━━━━━━━━━━━ 第17坑 ━━━━━━━━━━━━━━━━━━━━━━━━━━━━━━━━━━━━━━━━━━

【RS485自动方向模块与波特率强绑定】

日期：2026-08-18

【现象】57600波特率下21字节长帧响应CRC必错，前19字节内容却完全正确；115200下基本正常

【排查】F407抓帧正确 → Python原始串口抓帧 → 逐bit对比发现帧尾两字节被翻转、偶尔整字节丢失

【根因】MAX3485模块板载自动方向电路按115200字符时间(87μs)设计TX空闲超时；57600下最后一字节停止位174μs超过超时 → DE提前撤销 → 停止位被切断

【解决】波特率锁定115200（PCB版MAX13487为硬件自动方向，无超时概念，不受影响）

【教训】自动方向模块的波特率不能随意切换；"帧内容对、帧尾错"是方向切换时序问题的特征指纹；工业级方案=MAX13487或MCU引脚软件控制DE

六、CubeMX/工具类

━━━━━━━━━━━━━━━━━━━━━━━━━━━━━━━━━━━━━━━━━━ 第18坑 ━━━━━━━━━━━━━━━━━━━━━━━━━━━━━━━━━━━━━━━━━━

【CubeMX Generate Code后USER CODE块被重置】

日期：2026-07-26

【现象】加入FreeRTOS mqttTask后，sensorTask函数体被清空

【排查】CubeMX把旧的StartDefaultTask代码留在USER CODE BEGIN 5，重命名函数后代码丢失

【根因】CubeMX重命名Task时USER CODE标记对应关系断裂

【解决】手动重写sensorTask函数体

【教训】CubeMX加Task前备份关键函数代码；USER CODE标记不是100%可靠

━━━━━━━━━━━━━━━━━━━━━━━━━━━━━━━━━━━━━━━━━━ 第19坑 ━━━━━━━━━━━━━━━━━━━━━━━━━━━━━━━━━━━━━━━━━━

【孤儿while循环导致30个编译错误】

日期：多次

【现象】删除osKernelStart()后的死代码时残留while(1){}

【排查】主函数末尾和SystemClock_Config之间的孤儿代码块只删了一半

【根因】删代码时没确认括号匹配

【解决】完整删除死循环 + 保留USER CODE BEGIN/END 3标记 + main()的}

【教训】删代码时一次性定位到完整block，确认括号匹配

七、Qt上位机类

━━━━━━━━━━━━━━━━━━━━━━━━━━━━━━━━━━━━━━━━━━ 第20坑 ━━━━━━━━━━━━━━━━━━━━━━━━━━━━━━━━━━━━━━━━━━

【Qt6 QToolButton toggled信号递归调用崩溃】

日期：2026-08-08

【现象】点击"操作员视图"按钮，软件直接退出，无任何报错

【排查】调试发现onToggleView中先setText后setChecked，触发toggled信号递归调用栈溢出；findChild因objectName改变返回nullptr是次生问题

【根因】QToolButton checkable=true时，代码中setText被Qt内部二次触发toggled信号，形成递归调用

【解决】改用clicked信号替代toggled；去掉checkable；全局替换findChild为成员变量

【教训】QToolButton不要混用checkable+toggled+动态setText；控件查找优先用成员变量而非findChild

━━━━━━━━━━━━━━━━━━━━━━━━━━━━━━━━━━━━━━━━━━ 第21坑 ━━━━━━━━━━━━━━━━━━━━━━━━━━━━━━━━━━━━━━━━━━

【Qt5代码在Qt6编译报错】

日期：2026-08-08

【现象】setCodec不存在、addWidget不能链式调setStyleSheet

【排查】Qt6删除了QTextStream::setCodec（默认UTF-8）；QToolBar::addWidget返回QAction*而非QWidget*

【根因】Qt5→Qt6 API变化

【解决】删除setCodec调用，BOM字节直接输出；QLabel先创建后addWidget再setStyleSheet

【教训】Qt5→Qt6 API变化需要查阅官方Migration Guide；编译错误优先怀疑版本兼容性

━━━━━━━━━━━━━━━━━━━━━━━━━━━━━━━━━━━━━━━━━━ 第22坑 ━━━━━━━━━━━━━━━━━━━━━━━━━━━━━━━━━━━━━━━━━━

【Grafana Infinity数据源连接localhost:8080被拒绝】

日期：2026-08-08

【现象】Grafana面板无数据，数据源测试连接失败

【排查】定位为Grafana解析localhost为IPv6 [::1]，桥接只监听IPv4

【根因】IPv6/IPv4解析差异

【解决】URL改用127.0.0.1强制IPv4

【教训】本机服务连接优先用127.0.0.1，绕开localhost的IPv6解析歧义

━━━━━━━━━━━━━━━━━━━━━━━━━━━━━━━━━━━━━━━━━━ 第23坑 ━━━━━━━━━━━━━━━━━━━━━━━━━━━━━━━━━━━━━━━━━━

【桥接启动打印虚拟网卡IP 198.18.0.1】

日期：2026-08-08

【现象】MQTT桥接打印的WLAN IP是198.18.0.1而非真实IP，手机无法访问

【排查】connect(8.8.8.8:80)取路由接口返回了ST-Link虚拟网卡IP

【根因】路由接口探测被虚拟网卡干扰

【解决】改用getaddrinfo遍历网卡，过滤127.x/169.254/198.x

【教训】多网卡主机上获取"真实"IP必须过滤虚拟网卡网段

━━━━━━━━━━━━━━━━━━━━━━━━━━━━━━━━━━━━━━━━━━ 第24坑 ━━━━━━━━━━━━━━━━━━━━━━━━━━━━━━━━━━━━━━━━━━

【Mosquitto安装版与绿色版端口冲突】

日期：2026-08-08

【现象】绿色版Mosquitto启动失败，端口被占用

【排查】.msi安装版注册了Windows服务占用1883/3000端口

【根因】双版本共存导致端口冲突

【解决】绿色版改1884端口，配置custom.ini使用3030

【教训】同软件多版本共存时先查服务端口占用

八、黑匣子/存储类

━━━━━━━━━━━━━━━━━━━━━━━━━━━━━━━━━━━━━━━━━━ 第25坑 ━━━━━━━━━━━━━━━━━━━━━━━━━━━━━━━━━━━━━━━━━━

【黑匣子清空只清计数不清数据区】

日期：2026-08-18

【现象】上位机"清空记录"后重新采集，读取时第一条还是清空前的旧数据

【排查】发现Blackbox_ClearAll只把blackbox_count清零，不擦Flash数据区、不重置写指针idx

【根因】新记录从旧idx位置继续写，而读取从索引0开始 → 读到未擦除的旧数据

【解决】ClearAll改为三层全复位：擦除整个数据区 + count=0 + idx=0 + 保存元数据

【教训】"清空"语义=数据区+索引+元数据三层复位，只清一层必留旧数据；写指针与读指针必须同源

九、FreeRTOS类

━━━━━━━━━━━━━━━━━━━━━━━━━━━━━━━━━━━━━━━━━━ 第26坑 ━━━━━━━━━━━━━━━━━━━━━━━━━━━━━━━━━━━━━━━━━━

【vTaskSuspendAll在调度器启动前调用导致开机卡死】

日期：2026-08-18

【现象】烧录后开机串口输出两行日志就停，OLED无反应，按复位重跑卡在同一位置

【排查】日志停在SSD1306初始化之前，与Log_Write改动时间点吻合

【根因】Log_Write改用vTaskSuspendAll后，初始化阶段（调度器未启动）也调用了它，与启动时序冲突

【解决】xTaskGetSchedulerState()判断：调度器未启动时用关中断（此时无Modbus流量），启动后改用vTaskSuspendAll

【教训】FreeRTOS API有"调度器启动前不可调用"的隐含约束；初始化路径也要检查API前置条件

附：踩坑统计

类别 | 数量 | 单个典型耗时 | 总耗时估算
硬件接线 | 3 | 10-30分钟 | 约1小时
供电 | 1 | 20分钟 | 约20分钟
看门狗 | 3 | 30分钟 | 约1.5小时
传感器 | 3 | 20-40分钟 | 约1.5小时
通信 | 7 | 30分钟~2天 | 约2.5天
CubeMX/工具 | 2 | 15分钟 | 约30分钟
Qt上位机 | 5 | 30-60分钟 | 约3小时
黑匣子/存储 | 1 | 30分钟 | 约30分钟
FreeRTOS | 1 | 30分钟 | 约30分钟
合计 | 26 | | 约3.5天

每个坑均为真实遇到并解决，面试讲述模板："现象 → 我做了哪些排查 → 根因是什么 → 怎么解决的 → 得到了什么教训"。其中第11坑（HAL库UART状态机bug）耗时2天排查12个方向，是项目最大难题，也是最能体现调试方法论深度的一条。
