zhemufengtailang57-art/edge-vibration-diagnosis/firmware/Core/Inc/main.h

#define LED_Pin GPIO_PIN_0
#define LED_GPIO_Port GPIOC
#define W25Q64_CS_Pin GPIO_PIN_12
#define W25Q64_CS_GPIO_Port GPIOB
#define RS485_DE_Pin GPIO_PIN_8
#define RS485_DE_GPIO_Port GPIOC
#define BUZZER_Pin GPIO_PIN_0
#define BUZZER_GPIO_Port GPIOB
#define LED_Yellow_Pin GPIO_PIN_0
#define LED_Yellow_GPIO_Port GPIOA
#define LED_Red_Pin GPIO_PIN_1
#define LED_Red_GPIO_Port GPIOA
