zhemufengtailang57-art/edge-vibration-diagnosis/firmware/Core/Inc/cn_font.h

/*
 * cn_font.h - 16x16中文字库 (自动生成, SimHei黑体)
 * 每个字32字节, 含UTF-8字节查找表
 */
#ifndef __CN_FONT_H
#define __CN_FONT_H

#include <stdint.h>

#define CN_FONT_COUNT 37

/* UTF-8字节 → 字库索引 */
typedef struct {
    uint8_t b0, b1, b2;   /* UTF-8三字节 */
    uint8_t idx;          /* 字库索引 */
} CN_FontMap;

static const CN_FontMap CN_FONT_MAP[37] = {
    {0xE6, 0xAD, 0xA3, 0},  /* 正 */
    {0xE5, 0xB8, 0xB8, 1},  /* 常 */
    {0xE6, 0x9D, 0xBE, 2},  /* 松 */
    {0xE5, 0x8A, 0xA8, 3},  /* 动 */
    {0xE4, 0xB8, 0x8D, 4},  /* 不 */
    {0xE5, 0xB9, 0xB3, 5},  /* 平 */
    {0xE8, 0xA1, 0xA1, 6},  /* 衡 */
    {0xE6, 0x8C, 0xAF, 7},  /* 振 */
    {0xE5, 0x8A, 0xA8, 8},  /* 动 */
    {0xE7, 0x9B, 0x91, 9},  /* 监 */
    {0xE6, 0xB5, 0x8B, 10},  /* 测 */
    {0xE7, 0xB3, 0xBB, 11},  /* 系 */
    {0xE7, 0xBB, 0x9F, 12},  /* 统 */
    {0xE8, 0xBF, 0x90, 13},  /* 运 */
    {0xE8, 0xA1, 0x8C, 14},  /* 行 */
    {0xE7, 0x8A, 0xB6, 15},  /* 状 */
    {0xE6, 0x80, 0x81, 16},  /* 态 */
    {0xE6, 0x97, 0xB6, 17},  /* 时 */
    {0xE9, 0x97, 0xB4, 18},  /* 间 */
    {0xE4, 0xBC, 0xA0, 19},  /* 传 */
    {0xE6, 0x84, 0x9F, 20},  /* 感 */
    {0xE5, 0x99, 0xA8, 21},  /* 器 */
    {0xE6, 0xB8, 0xA9, 22},  /* 温 */
    {0xE5, 0xBA, 0xA6, 23},  /* 度 */
    {0xE9, 0xA2, 0x84, 24},  /* 预 */
    {0xE8, 0xAD, 0xA6, 25},  /* 警 */
    {0xE6, 0x95, 0x85, 26},  /* 故 */
    {0xE9, 0x9A, 0x9C, 27},  /* 障 */
    {0xE5, 0x88, 0x9D, 28},  /* 初 */
    {0xE5, 0xA7, 0x8B, 29},  /* 始 */
    {0xE5, 0x8C, 0x96, 30},  /* 化 */
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
    {0x00, 0x00, 0x01, 0x80, 0x01, 0x80, 0x01, 0x80, 0x7F, 0xFE, 0x03, 0xC0, 0x03, 0xC0, 0x07, 0xE0, 0x05, 0xA0, 0x0D, 0xB0, 0x19, 0x98, 0x37, 0xFC, 0x67, 0xF6, 0x01, 0x80, 0x01, 0x80, 0x01, 0x80},
};

#endif /* __CN_FONT_H */
