zhemufengtailang57-art/edge-vibration-diagnosis/firmware/Core/Inc/ai_model.h

/*
 * ai_model.h - int8量化MLP权重 (自动生成)
 * 结构: 5输入 -> 16隐藏(ReLU) -> 8隐藏(ReLU) -> 3输出
 * 量化: 对称int8, 精度损失0.00%
 */
#ifndef __AI_MODEL_H
#define __AI_MODEL_H

#include <stdint.h>

#define AI_INPUT_SIZE   5
#define AI_HIDDEN1_SIZE 16
#define AI_HIDDEN2_SIZE 8
#define AI_OUTPUT_SIZE  3

static const float AI_MEAN[5] = {
    1057.721649f, 2641.840206f, 4192.278351f, 3952.860825f, 4736.185567f,
};
static const float AI_STD[5] = {
    1048.566653f, 2615.834500f, 3315.137885f, 2922.215489f, 3096.440188f,
};

/* 量化scale: 反量化 = int8_value * scale */
static const float AI_W1_SCALE = 0.007983f;
static const float AI_B1_SCALE = 0.005727f;
static const float AI_W2_SCALE = 0.008867f;
static const float AI_B2_SCALE = 0.006121f;
static const float AI_W3_SCALE = 0.009471f;
static const float AI_B3_SCALE = 0.004901f;

static const int8_t AI_W1[16][5] = {
    {-38, -20, -81, -5, -13},
    {25, 33, 93, -32, 26},
    {-11, -4, 98, 93, -69},
    {-18, -116, 38, 65, 62},
    {-67, 15, -31, 56, -67},
    {-106, -65, -93, 25, 48},
    {-127, -1, 23, -6, 35},
    {91, -45, 2, 37, -52},
    {-16, -26, -72, -72, -71},
    {86, 7, -17, -51, -2},
    {-39, -20, -45, -32, 50},
    {85, 8, 57, -16, 53},
    {101, 11, -16, -15, 5},
    {-83, -70, -21, -37, -70},
    {-110, 4, -84, 13, -38},
    {-113, -34, 41, 3, -2},
};
static const int8_t AI_B1[16] = {
    29, 66, 35, -13, -57, 4, 54, 102, 49, 69, -102, 92, 127, 41, 1, 57,
};

static const int8_t AI_W2[8][16] = {
    {-32, 102, 98, 67, 0, 19, 22, -30, -46, -80, -4, -2, -2, 56, -49, 48},
    {-20, -6, 100, 87, 26, 39, -10, 41, -26, 0, -15, 13, 0, -24, -49, 87},
    {-59, 12, 65, 53, -29, -19, 13, 97, 24, 51, 38, 59, 14, -40, -16, 12},
    {0, 42, 54, -51, 1, 92, 28, -73, 43, -127, -10, 11, -82, 98, 65, 91},
    {-69, -24, 23, -25, -52, 36, -66, 44, -12, 39, -63, 31, 69, -5, 3, -11},
    {9, -54, -42, -11, -22, -26, -29, 24, 32, -36, -49, -35, 39, -61, -36, 2},
    {-3, -8, 34, 41, 30, -15, 28, 17, 24, 49, 24, -16, 78, -31, 12, -72},
    {40, -22, 20, 104, -119, -60, -82, 75, 8, 2, 3, 70, 70, 69, -38, -20},
};
static const int8_t AI_B2[8] = {
    24, 9, 127, 9, 60, 13, 80, 57,
};

static const int8_t AI_W3[3][8] = {
    {71, 106, 52, 25, -110, 60, -23, -73},
    {-61, -125, -93, 127, 37, 61, -52, -117},
    {-99, -35, 105, -52, 42, 67, 68, 61},
};
static const int8_t AI_B3[3] = {
    54, 127, 84,
};

#endif /* __AI_MODEL_H */
