zhemufengtailang57-art/edge-vibration-diagnosis/(commit log)

2026-09-16 初始提交：工业设备振动监测与边缘故障诊断系统
    STM32F407 + FreeRTOS 边缘振动诊断终端完整工程：
    - firmware/ STM32F407 固件（Keil MDK + CubeMX）
    128 点 FFT 特征提取、int8 MLP 手写推理引擎
    Modbus-RTU 从站、事件型黑匣子、四任务优先级分层
    - host-qt/ Qt 6 上位机（波形显示 / 频谱分析 / 黑匣子回放）
    - ai/ Python 全流程（采集 → 训练 → int8 量化 → 导出 C 头文件）
    - esp32/ ESP32 无线通道（MQTT）
    - docs/ 开发日志 / 调试踩坑记录 / AI 研发记录
    关键指标：
    模型 5->16->8->3，259 参数，int8 量化后权重 259 字节（较 FP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
    [loose_duty600_20260816_205532.csv, loose_duty600_20260817_195719.csv, loose_duty700_20260816_211000.csv, loose_duty800_20260816_212522.csv, loose_duty900_20260816_214548.csv, loose_duty999_20260816_220515.csv, normal_20260815_172642.csv, normal_duty600_20260816_205105.csv]
2026-09-16 新增 hardware/ 硬件设计：原理图 5 页 + PCB Layout + 嘉立创EDA 工程源文件
    - schematic/ 原理图 5 页，由嘉立创EDA 导出为 PNG
    ① STM32最小系统 ② 电源树 ③ 传感器 ④ 电机与输出 ⑤ 通信接口
    GitHub 上可直接预览，无需安装任何 EDA 工具
    - pcb/ PCB Layout 总览（V1.0）
    - *.epru 嘉立创EDA 专业版工程源文件，可编辑
    - README.md 器件清单、电源树、四个设计要点（电源隔离 / RS485 自动方向 /
    传感器端子化 / 磁珠隔离）
    主 README 新增「硬件设计」章节，首屏加入 PCB Layout 图，后续章节编号顺延。
    Co-Authore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
2026-09-16 更新硬件图纸至最新版，补充 4 层板叠层信息
    图纸来源：2026-09-16 从嘉立创EDA 重新导出
    （SCH_Schematic1_2026-09-16.pdf / PCB_PCB1_2026-09-16.png / 3D_PCB1_2026-09-16.png）
    - schematic/ 原理图 5 页全部替换，由 PDF 按 200 DPI 重新渲染
    更新日期分别为 08-13 ~ 08-27，较上一版（08-16 云端备份）更新
    - pcb/ PCB Layout 替换为最新版
    - pcb/ 新增 3D 渲染图 VibrationMonitor_F407_3D.png
    - hardware/README.md 补充板卡规格：4 层板，叠层 信号 / GND / 电源 / 信号
    设计要点新增「4 层板叠层」并重排为 5 条
    主 README 首屏改用 3D 渲染图，硬件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
